chronox142857/FPGA2026/README.md

# FPGA2026 — FPGA 协议自识别逻辑分析仪

AMD 初级组 / 正点原子领航者 ZYNQ7010 / Vivado + SDK 2018.2。

本机主项目位置：`E:\FPGAproject\FPGA2026`。

原开发计划的逐项进度与后续分工见[项目状态（2026-10-31）](docs/PROJECT_STATUS.md)，区分实物通过、仅仿真通过、待开发及待修复项目。

交给另一开发对话的完整任务见[STM32独立信号源开发要求](docs/STM32_SIGNAL_SOURCE_REQUIREMENTS.md)：先确认具体板型，再生成已知UART/I²C/SPI信号。本对话维护FPGA主项目，单片机工程独立存放。

8 路、32 KiB 环形采样缓存，1/5/10/25/50 MSa/s；立即、上升沿、下降沿、电平组合触发；0/25/50/75% 预触发；ARM 裸机分析 UART / I²C / SPI；128×128 SPI TFT 显示与双按键操作。

**这是首版工程源码。仿真、构建和上板状态请看 [验证记录](docs/VALIDATION.md)。ST7735S独立PL例程已完成实物全屏填色验收；整合版由ARM提交四页界面及协议结果，KEY0切页已确认；UART/SPI已完成同板真实引脚回接，独立设备、完整性能范围及显示长期稳定性仍待验收。**

**后续实测更新：** 用户更换SDA线后，在GitHub原版下确认屏幕恢复；测试期间的碎字经全屏重画后清楚，局部刷新稳定性仍待专项验证。本轮保持发布版FPGA和显示初始化，仅修正ARM UART窗口起点与错误停止位后的帧对齐。12992组新增边界语料及原完整回归通过，板上正常/错误UART均已核对；连续采集和后续SPI结果见[验证记录](docs/VALIDATION.md)。未提高刷新速度。现已完成[SD卡首次独立冷启动](docs/SD_BOOT.md)：卡内保留BOOT.bin、BOOT_CFG 1/2均OFF，断电后可自动加载，不必每次JTAG下载；未写板载Flash。

SPI验证结果发布后，用户再次反馈上方约1/3乱码。未重新下载程序，仅请求整屏重画后用户确认乱码消失、文字清楚。因此显示稳定性仍未通过，不能将协议采集核对通过等同于整机显示验收完成。

## 当前整合版

SD启动保存版本：`sd-boot-20261031`，[BOOT.bin、校验与冷启动证据](releases/sd-boot-20261031/README.md)。BOOT_CFG 1/2均OFF，卡留在板内；日常JTAG调试不必反复拔卡，功能通过后再更新卡根目录BOOT.bin。JTAG临时程序断电后会被卡内版本替代。

本轮程序版本：`analyzer-selftest-20261031`，[程序、UART原始证据与恢复说明](releases/analyzer-selftest-20261031/README.md)。UART真实回接100次正常采集、8次错误停止位检查通过；同一程序又完成SPI四模式×四档预触发×AUTO/手动共32组实物核对，[SPI证据标签spi-loopback-20261031](releases/spi-loopback-20261031/README.md)。I2C等待上拉电阻，显示提速尚未开始。

版本标签`analyzer-st7735s-integrated-20261031`；[发布文件和恢复说明](releases/analyzer-st7735s-integrated-20261031/README.md)。保留已点亮的PL显示驱动，ARM负责采样读取、UART/I²C/SPI识别、四页界面和按键调度；显示初始化与PS复位隔离。KEY0短按切页，KEY1长按启动/取消采集，满屏刷新约1.2秒。测试源上电默认关闭，需要按接线文档回接后验证真实采集。

## 已验证的小屏版本

[ST7735S独立PL例程](examples/st7735s_pl/README.md)保存源码、接线、构建脚本及下载文件。当前文字版标签`st7735s-text-20261031`，采用原项目5×7字模，用户确认屏幕已有显示内容；`artifacts/`保存当前文字bit和电脑预览。已验证全屏五色版本仍保留标签`st7735s-fullscreen-20261030`及`artifacts/fullscreen_20261030/`配套bit/ltx。两版共享两段150ms等待和窗口偏移2/3，文字页明确标记DISPLAY TEST / CAPTURE OFF，真实采集数据尚未接入。

## 快速开始

在 PowerShell 中进入仓库目录：

```powershell
# 默认使用本机已发现的工具路径，可通过参数覆盖。
./scripts/test.ps1 # 含四页ARM画布→AXI→SPI全像素测试
./scripts/build.ps1 -Stage All
```

- `test.ps1`：编译运行可移植 C 分析器及界面测试；调用 XSim 验证 RTL；将 RTL 产生的 UART、I²C、SPI 四模式采样重新交给同一套 C 分析器验证。
- `build.ps1`：生成 block design、综合、实现、输出 bit/HDF，再构建 ARM ELF。
- 分阶段使用 `-Stage Project`、`Hardware`、`Software`。
- `-Vivado`、`-Sdk` 可覆盖安装路径；测试的 `-Gcc` 可指定 Windows GCC，`-HostOnly` 只运行 C 测试。
- 输出位于 `build/export/`。源代码不依赖已有 `.xpr`、其他人的生成文件或 2020.2 IP。

构建时临时用空闲 T:～Z: 映射仓库，结束后解除，以避开 2018.2 的 Windows 长路径问题。该过程不修改系统环境变量或删除工程文件。生成的工程引用这个短路径；直接用 Vivado 查看时需重新映射到构建时同一盘符，或在短目录下重新生成。

## 使用与文档

- [接线、屏幕配置和首次启动](docs/HARDWARE.md)
- [操作、串口命令、演示流程](docs/USER_GUIDE.md)
- [寄存器和软硬件接口](docs/INTERFACE.md)
- [验证结果与剩余事项](docs/VALIDATION.md)
- [架构、识别范围和局限](docs/ARCHITECTURE.md)
- [SD卡自动启动与调试/更新流程](docs/SD_BOOT.md)
- [当前完成度及后续分工](docs/PROJECT_STATUS.md)
- [转交STM32开发对话的信号源任务书](docs/STM32_SIGNAL_SOURCE_REQUIREMENTS.md)

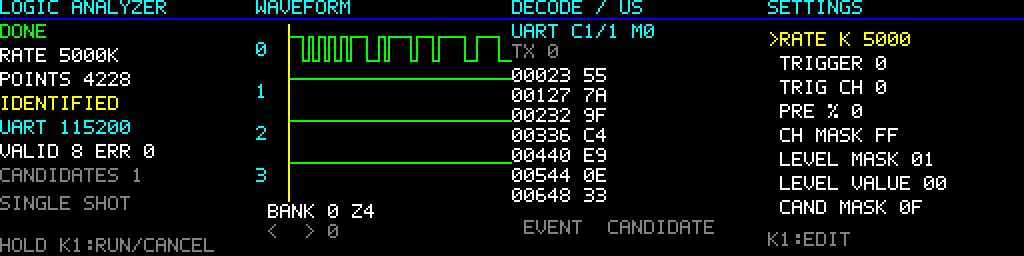
[picture p1: docs/ui-preview.png]
128×128屏幕四页布局预览（电脑渲染，2倍放大）


目录：`rtl/` 为 Verilog-2001；`firmware/` 为 ARM C 和可在电脑测试的分析器；`tests/` 为独立测试激励；`scripts/` 为重建、测试、调试入口；`constraints/` 为参考引脚约束。

## 实现选择

- 应用运行和采集使用 Cortex-A9 片内 OCM/PL BRAM；主工程关闭DDR。SD启动路径另由已核对的7010 FSBL初始化DDR，临时放置加载器再交接OCM应用，不是DDR采集功能。
- 所有 PL 数据通路、AXI 控制和 BRAM 控制器共享板上 50 MHz 时钟；PS 自己的时钟域由官方 AXI 接口处理。异步输入有两级同步，复位由 `proc_sys_reset` 同步释放。
- 先完成一次采集，再分析和显示；循环模式也有分析／显示间隙。
- 自动识别最多搜索 4 路候选通道。SPI 模式、收发方向可能有歧义，界面会显示 `AMBIGUOUS`，可手动指定。
- 评分表示规则匹配程度，不是经过统计标定的概率。测试集通过不表示所有未知信号都能被正确识别。
- 屏幕芯片确认是 ST7735S，屏体标记为 `14PIN HD14008H14 JY`，采用128×128 SPI方案；3.3V供电、偏移2/3、填色/文字和整合版KEY0翻页已实测，偶发局部乱码的长期稳定性仍待解决。
- 支持JTAG临时下载和已实测的SD独立启动，不自动写入Flash。日常调试用前者，固化可演示版本时更新卡内BOOT.bin。

## 参考资料

开发参考本机配套 FPGA 例程中的器件、时钟和引脚配置；未复制其带版权声明的 RTL。PS/AXI 使用 AMD 随 Vivado/SDK 提供的 IP 和驱动。控制芯片资料：[Sitronix ST7735S 数据手册（厂商镜像）](https://files.waveshare.com/upload/e/e2/ST7735S_V1.1_20111121.pdf)。同类模块参考：[Waveshare 128×128 SPI 屏说明](https://www.waveshare.com/wiki/1.44inch_LCD_HAT)，不代表本项目屏幕就是该模块。
