chronox142857/FPGA2026/docs/PROJECT_STATUS.md

# 原开发计划对照进度（2026-10-31）

本表按源码和最新验证证据归类。实物回接通过只覆盖记录中具体配置；仿真通过不能替代实物验收。当前主体已开发，整机最终验收尚未完成。最新记录见 VALIDATION.md，验收方法见 ACCEPTANCE.md。

## 已开发且有验证证据

| 内容 | 已验证范围 |
|---|---|
| 工程与工具链 | Vivado/SDK 2018.2重建、综合、实现、时序/DRC检查、ARM裸机程序构建通过，板上程序运行 |
| 采集与ARM读取闭环 | 8路/32768点/32KiB架构已实现；实物在5MSa/s下以UART单路、SPI四路回接，逐点核对ARM样本与冻结BRAM一致；不代表8路全部和所有采样档均已实测 |
| 触发、缓存、时间与配置锁存 | 五档采样使能、四类触发、四档预触发、回绕/冻结/取消/重复启动/配置锁存有RTL测试；四档预触发及下降沿触发另有实物记录 |
| UART识别和解析 | 同板115200 baud、8N1自动识别；100次正常采集通过，四档预触发各25次；8次坏停止位测试按手动UART参数核对错误及后续字节。异常流手动通过不算自动识别成功 |
| SPI识别和解析 | 同板100kHz、四模式×四档预触发×AUTO/手动共32组通过；AUTO保留正确候选并报告歧义，手动模式逐字节核对两方向和样本位置；不宣称AUTO唯一判断模式/方向 |
| 小屏基础显示与KEY0 | ST7735S初始化、窗口偏移、填色、文字、四页界面和KEY0切页有实物确认；画布到AXI到SPI像素路径另有仿真；显示长期稳定性另列未完成 |
| 自动化测试 | 原81项协议检查、12992组UART边界语料、100次缩小深度RTL采集、AXI、默认深度三协议贯通、显示像素路径通过；不能替代独立设备测试 |
| SD启动 | 首次独立冷启动通过，用户确认文字清楚和KEY0切页；只读核对SD模式、发布版主程序、接口和运行状态。卡保留、BOOT_CFG两位均OFF即可启动；未写Flash |

UART/SPI回接使用本板自测发生器，经外部短线回到真实采集输入，验证了完整引脚和软件链路；发生器与采集同源时钟，不能据此证明独立设备兼容性、相位适应性或绝对时钟精度。

## 已开发，但实物验证不完整

| 内容 | 剩余验证 |
|---|---|
| 8路输入、通道掩码与五档采样率 | 当前实物集中于CH0及CH0～3、5MSa/s；补8路、1/10/25/50MSa/s和掩码组合 |
| 四类触发和控制边界 | 补立即/上升/电平组合实物矩阵、长时间等待后回绕、取消和重复启动、采集中修改配置；检查会话统计和冻结窗口的区别 |
| 时间精度 | 用独立时钟改变相位和脉宽，核对同步延迟、采样量化、首/末边沿与计数；同板源不能标定绝对频率 |
| UART完整速率范围 | 外部源验证9600～1Mbaud、变化数据/空闲/截断/坏停止位及误识别；现有实物仅115200 |
| I²C | 解析器、自动角色判断、7位地址、方向、ACK/NACK、START/重复START/STOP及速率估计已写，软件/仿真通过；尚无实物通过记录，待带上拉的独立源验证100k/400k/1MHz |
| SPI完整指标 | 独立时钟、不同角色接线/数据图样、逐步提高至5MHz；已通过100kHz同板四模式不等于最高速验收 |
| 识别可靠性 | UNKNOWN/AMBIGUOUS、候选评分、手动参数已有实现及测试；补真实静态输入/反例/通道换序/三协议切换及固定测试集识别率、误判率统计 |
| 完整菜单交互 | 波形分组、缩放、平移、触发标记、解析翻页、设置、KEY1长按/取消/返回都有代码；KEY0已确认，其余要按真实操作逐项验收 |
| 单次与循环 | 主循环调度已写；UART测试器驱动100次通过，不能代替脱离JTAG、由按键启动的长期循环和所有协议稳定性验收 |
| 串口辅助配置/导出 | 参数命令、状态、dump已有代码；补完整命令和导出内容/使用体验的独立串口验收 |
| 局部刷新 | 影子画布、变化矩形已有实现及仿真；实物曾碎字/局部乱码，整屏重画恢复，根因尚未定，稳定性未通过 |
| 板载自测源 | UART/SPI实物已用，I²C仅仿真贯通；源固定速率，不能覆盖完整速率范围 |
| SD启动复现 | 首次冷启动已通过；多次冷启动统计、长时间独立运行未做 |

解析结果当前最多保留前128个条目并记录溢出，原始32768点仍完整保存。尚未实现任意长度解析结果全部浏览。

## 尚未开发或未完成的交付项

| 内容 | 当前边界 |
|---|---|
| 提高刷新率/专门加速数字区 | 尚未开始；先解决乱码与局部更新稳定性，再验证提速和非阻塞交互 |
| 新800×480 RGB屏与触摸 | 尚未实现RGB时序、显示缓存/带宽方案、GT1151/GT9147触摸及新界面布局；这些GT型号是触摸控制器，不代表LCD显示驱动 |
| 完整比赛演示和验收包 | 未完成三类独立输入的采集→识别→解析→显示、异常/无法确定演示、录像、最终复现说明及正式赛题指标逐条核对 |
| 扩展项 | SD历史记录、DDR深度采集、DMA、更多协议、板载Flash自动启动尚未开发。SD启动文件已实现，不等于SD历史记录已实现；启动临时使用DDR，不等于DDR采集已实现 |

当前显示使用已经点亮的Verilog ST7735S驱动和AXI画布桥，ARM负责界面。原计划的AXI Quad SPI+GPIO显示方案已由此方案替代，不能再把旧方案计作待实现模块。

## 后续分工和顺序

- 本对话负责领航者板上的Verilog采样/触发/缓存/接口、ARM裸机识别和解析、显示/按键/启动、测试与文档。
- 外部STM32等单片机信号源由用户另一个对话开发，本对话不承担该固件实现，也不自动给另一个对话发送消息。
- 可直接转交另一对话的任务书见[STM32独立信号源开发要求](STM32_SIGNAL_SOURCE_REQUIREMENTS.md)，明确型号确认、接线、独立操作、测试包、协议/异常用例及交付物。
- 原范围识别UART、I²C、SPI。若单片机发送自定义上层业务帧，当前恢复底层字节，不会自动理解新增业务协议语义。
- 优先补显示稳定性与板内可独立完成的验收；外部源就绪后导入已知数据和源参数，完成独立时钟、完整速率、触发/异常/角色换序测试，再完成三协议演示。
- 使用现有小屏无需新显示模块；I²C总线需要合适的上拉，若信号源已有则核对后复用。外部源与采集端共地，使用与当前输入匹配的3.3V逻辑。具体信号源板引脚由另一对话确定。

版本保存：UART程序标签`analyzer-selftest-20261031`，SPI证据标签`spi-loopback-20261031`，本次SD启动文件与证据保存于[sd-boot-20261031](../releases/sd-boot-20261031/README.md)，配套源码/重建脚本和本状态说明随本次更新提交。项目位置为 `E:\FPGAproject\FPGA2026`。
