chronox142857/FPGA2026/docs/VALIDATION.md

# 验证记录

验证日期：2026-10-29～31，Asia/Shanghai。主项目：`E:\FPGAproject\FPGA2026`。

阅读顺序：本文件保留各阶段原始结论，包括后来修复的失败；以[当前项目状态](PROJECT_STATUS.md)及本文件顶部后续验收为准。外部单片机开发边界和测试激励见[信号源需求书](STM32_SIGNAL_SOURCE_REQUIREMENTS.md)。

## SD卡首次独立冷启动（2026-10-31）

原7010纯PL固化FSBL能从卡加载FPGA、DDR加载器和完整应用，但在0xE6E4停住、未调用已有FsblHandoff。核对具体供应商ELF哈希和指令后，构建脚本仅修正该交接指令；现有FPGA bit、ARM ELF、显示初始化、250kHz SPI均不变。先用JTAG临时交接验证路径，用户确认文字和翻页正常，此项单独标为辅助验证。

随后修正版BOOT.bin写入用户确认的D: FAT32可移动卡并读回校验。用户安全移卡、开发板OFF/OFF冷启动后确认文字清楚、KEY0能切页。只读复核BOOT_MODE=5，REBOOT_STATUS=0x00400000，OCM主程序与发布ELF一致，采集/显示ID正确、显示状态=1、帧数=5、screen_ok=1、应用循环时间持续前进。复核期间没有下载、暂停CPU、复位或写目标寄存器。日志：`build/sd_boot/cold_check/20261031_170331_569427/status.log`，启动文件SHA256为`857c88573bd738ccbe17c9ef34cbe2df8b012ae5407ca8e580d948f7fd58fbff`。

首次完整冷启动通过；卡必须保留在板内。未做多次冷启动统计、未写Flash，不据此关闭偶发显示乱码问题。构建依赖准确的本地7010 FSBL；启动阶段使用其DDR初始化，应用采样/分析仍用原OCM和BRAM布局。步骤见[SD启动说明](SD_BOOT.md)。下文早期“仅JTAG启动”记录为当时状态。

## 换SDA线后恢复与本轮UART修正（2026-10-31）

用户更换SDA杜邦线后，在同一份3b3488e原bit/ELF下反馈屏幕恢复正常。这支持继续检查信号连接的判断，但没有测量线材通断/动态波形，不能断言此前所有白屏的唯一原因就是该线。随后UART测试期间，用户反馈能切页但文字呈碎点；通过已有first_frame标志请求全屏重画后，用户确认文字清楚。此轮未提高SPI时钟或数字刷新频率，局部刷新稳定性仍待专项验证。

测试发现正常UART在75%预触发、窗口从字节中间开始时，会把残缺片段误报成FE字节。使用保存的真实32768点样本复现后修正：优先利用观察到的完整空闲区间确定帧起点，开头不可信片段标记TRUNCATED；长空闲后的有效帧不反过来为之前残片提供锁帧证据；停止位错误与下一起始位同为低电平时保留已知位边界，避免把下一数据边沿当作起始位。丢弃较大前缀会降低候选评分，保留原非标准波特率测试，避免更高波特率谐波因裁剪前缀获得更高分。

- 新增独立绝对时刻波形/数据/错误标志核对：12992个窗口，变化起始相位和16种起始数据，正常与错误停止位均通过。此语料带包间空闲，不证明任意无空闲波形都能唯一恢复帧边界。
- 原81项协议测试、100次缩小深度采集仿真、AXI测试、默认32768点UART/I2C/SPI四模式贯通，以及ARM画布→AXI→SPI五帧全像素/局部矩形测试均通过。
- SDK2018.2生成新ARM ELF，text=46872、data=1152、bss=127616；OCM布局上界仍为0x2B280。仅临时更新ARM，FPGA仍为发布版bit（SHA256=5a5ab497473bd2c398564e56c259ac9d310481d47916d911369a5ff6a4363a16），未更改显示初始化。
- 新ARM在75%预触发实测正常，32768点、5MSa/s、AUTO UART115200、40个有效字节、0错误；错误源用手动UART115200核对，39个有效字节、6个错误停止位，所有完整输出字节仍符合0x13递增及独立位中心核对。异常源此项是手动参数验证，不计作异常流自动识别成功。
- 100次真实UART回接全部通过：0/25/50/75%预触发各25次，32768点、5MSa/s、AUTO UART115200，每次40～48个有效字节且0错误，100个触发时间戳严格递增。每次都逐字节比较冻结BRAM和ARM样本，并核对触发位置、时间关系及已知数据序列。测试器在记录之间短暂停ARM导出证据，不等同于无间隙实时采集或已完成所有协议的100次验收。
- 另做8次错误停止位实物回接，四档预触发各2次，手动UART115200；每次35～42个有效字节、5～6个错误停止位，完整字节和错误标记均通过独立位中心及0x13序列核对。已锁定的本测试源在坏停止位后能维持字节边界，不代表任意BREAK/噪声条件都能恢复。
- 汇总保存在`build/hardware_selftest/20261031_154836_035254_uart0/`（100次正常）和`20261031_155206_805771_uart-error0/`（8次异常）。UART程序和证据已发布为analyzer-selftest-20261031；SPI后续实测见下节，I2C缺少上拉电阻，尚未执行实物测试。

本轮正常板载源约115200 baud，不能替代9,600～1,000,000 baud异步独立设备验证；源和采样同板共时钟，不能标定绝对频率。测试脚本在结果页请求全屏重画，不等同于已实现局部数字刷新优化。

## SPI四模式真实回接（2026-10-31）

用户确认四根SPI短线回接完成后，完整重新下载analyzer-selftest-20261031保存的bit和ELF。FPGA bit及ARM ELF的SHA256分别仍为5a5ab497473bd2c398564e56c259ac9d310481d47916d911369a5ff6a4363a16及7f78db8cf2852305b9eed6ad6f7f657b1fb02c0b58c62bafa363501b4177d4e8；没有修改固件或显示参数。

| 源模式 | AUTO（四档预触发） | 已知模式/角色手动核对（四档预触发） |
|---|---|---|
| SPI 0 | 4/4通过 | 4/4通过 |
| SPI 1 | 4/4通过 | 4/4通过 |
| SPI 2 | 4/4通过 | 4/4通过 |
| SPI 3 | 4/4通过 | 4/4通过 |

- 共32组完整矩阵，5MSa/s、32768点，0/25/50/75%预触发，每次触发于CH3的CS下降沿。逐点比较ARM读取和按环形起点展开的物理BRAM；检查触发索引、CS边沿、启用通道、时间戳关系，32次触发时间均不同。
- 16次AUTO均首选SPI、100000Hz、AMBIGUOUS；候选包含实际接线角色SCK/MOSI/MISO/CS及源模式，未把收发方向或相位歧义误报为唯一确定。AUTO并不等同于已唯一确定实际模式。
- 16次手动核对指定实际角色及模式。独立读取原始物理线路的已知采样边沿，对完整CS区间核对两字节相同、后续事务按0x13递增、MISO与MOSI互补；每次19～20个完整事务，ARM输出字节及起止样本序号与该核对一致。
- 每次共有39～41个完整字节，末尾另有1个采集窗口截断标记。已断言该错误计数仅来自end_sample=32767的TRUNCATED DESELECT，完整CS事务没有结构错误；不把窗口末尾截断当成源产生了坏帧，也不把它隐藏成0错误。
- 全部32组在导出后再次用最终核对脚本离线重验，覆盖新增的CS下降沿和窗口末尾截断断言。程序/FPGA无需重编译。最后另做一次模式0 AUTO并留在解析页，关闭自测输出；运行状态核查通过，ARM恢复运行。
- 用户确认重新上电下载后“小屏文字清楚，显示正常”。测试结果页使用整屏重画，没有提高刷新速度；不据此宣称局部刷新稳定性或长期显示验收已完成。

发布证据：`releases/spi-loopback-20261031/`，含32组汇总、完整原始采样/寄存器/事件压缩包、最终运行状态及SHA256。源码程序仍使用前一标签的同一份产物。尚未进行SPI最高5MHz、独立从机/独立时钟、更多字长/位序或SPI实物100次循环验证；UART100次不能替代这些项目。

### SPI验证之后再次局部乱码

SPI证据提交/推送期间，用户报告上方约1/3出现乱码，并询问是否正在更新板上程序。当时仅在进行GitHub操作，没有重新下载固件或修改刷新速度，发生器输出已关闭。收到反馈后只读两次显示状态，间隔1秒，帧计数均为37（0x25），状态1；主机ui_pixels与shadow逐字节一致。此观测不证明乱码出现的确切时刻没有其他刷新，也不证明实际LCD收到的像素正确。

随后根据当前ELF动态取得first_frame/last_paint符号地址，暂停ARM设置整帧重画标志后恢复，没有复位FPGA或重发初始化。2秒后帧计数38（0x26），用户确认“乱码消失，文字清楚”。日志和画布快照在`build/spi_corruption_full_refresh.log`、`build/spi_corruption_ui.bin`及`build/spi_corruption_shadow.bin`。这再次证明该次异常可由整屏重画恢复，不能据此确定是局部刷新实现、串行传输还是电气因素中的哪一项导致。

当前显示稳定性仍未验收；UART/SPI原始采集与解析的核对结果保留，不等同于整机显示验收。后续刷新率优化应先处理局部乱码复现和整帧恢复条件，不将一次清晰画面当作长期稳定。

## 历史实测与白屏复现（2026-10-31，UART修正前）

2026-10-31后续已用短线P15→W18完成真实UART回接，使用既有FPGA发生器、同一块板的时钟，非独立设备验证：

- 5MSa/s、32768点、115200 baud；正常UART的0/25/50/75%预触发均通过。实际触发索引0/8192/16384/24576，下降沿与元数据时间关系正确。
- 每次ARM样本与冻结BRAM按环形起点展开后32768字节完全相同；自动UART结果115200，完整字节按0x13递增，46～48个有效字节、0帧错误。另有初次25%记录47字节。
- 故意破坏停止位时检出错误，但异常之后的字节序列恢复检查失败；不能将错误计数增加当作完整异常恢复验收。原始数据保存在`build/hardware_selftest/*_uart-error0/`，正常记录在相邻目录。该问题尚未修复。
- 用户反馈白屏持续，确认没有按复位或插拔操作，但不确定何时开始。只读检查显示ARM刷新计时继续更新、记录和UART识别正常、显示状态无内部错误；这不能证明LCD正确收到并显示。
- 按用户要求重新下载Git标签保存的整合bit/ELF，校验完全相同，用户仍反馈全白屏、LED0闪。因此原来的菜单点亮不能稳定复现，显示稳定性验收不通过，协议自测已暂停。

历史启动实验：显示桥版本改为0x4C440102，上电保持LCD复位，ARM在PS启动和MMIO可用后通过COMMAND=4明确启动初始化。原初始化字节和150ms等待不变。新增ARM显式启动/重复初始化仿真通过，但用户反馈仍全白，实验没有解决故障。当前源码已恢复发布版0x4C440101，失败实验备份保留在build中。

实验版当时已完成Vivado/SDK构建并临时下载，显示ID=0x4C440102、screen_ok=1、首帧完成。WNS+8.625ns、WHS+0.040ns，TNS/THS=0；LUT2187、FF3181、BRAM16、DSP2。候选修改和构建日志保存在`build/display_explicit_start_snapshot/`，源码备份在`build/failed_display_start_source/`；不作为当前板上版本或成功显示证据。

## 早期整合版快照（2026-10-31）

主体采集/协议分析/四页界面已接入已点亮的ST7735S Verilog驱动。此节记录初次整合时的状态；后续UART/SPI/SD启动结果见本文件上方，不能将下方“尚未回接”等旧结论视为当前状态。2026-10-29～30的ARM SPI/GPIO排查与资源数字同样保留为历史。

- 保留独立例程驱动原文件：profile 2、窗口偏移2/3、MADCTL C8、两段150ms等待、约250kHz、字节末SCK高；没有重写已点亮的初始化。
- 新增`la_display`，AXI 0x44A00000、32KiB PL画布和矩形刷新；采集缓存与显示缓存独立。ARM不直接操作屏幕引脚、不读取LCD寄存器。旧色块诊断循环移除，正常运行采集/分析/菜单。
- 完整`test.ps1`通过：81项协议检查、100次仿真采集、AXI、默认32768点的UART/I2C/SPI四模式贯通、UART错误注入、旧pad回归。
- 新增生产C画面/传输测试：用RTL UART样本进行真实解码，生产`ui.c/tft.c`生成四页画面及MMIO轨迹，Verilog重放AXI并从实际SPI输出重建GRAM，四页全部16384像素相同；另有局部修改第五帧、部分byte strobe/奇数坐标矩形、忙时拒写、无变化跳过、越界拒绝、初始化77字节和150ms等待检查。`test_display.c`还覆盖初始化错误/超时与空指针。
- Vivado2018.2完成重建、综合、布局布线和bit/HDF生成；WNS +9.878ns、WHS +0.041ns，TNS/THS=0；LUT2046、FF3115、BRAM16、DSP2；DRC无错误/严重警告，五条普通DSP流水线建议。
- SDK2018.2严格警告编译并链接成功：text46488、data1152、bss127616字节；链接末地址0x2B280，低192KiB OCM剩余19840字节；堆栈已计入布局。
- 第一版整合程序虽通过仿真，用户仍反馈白屏。随后将显示复位与PS/AXI复位分离，保留独立版65536周期上电等待与两级同步释放，同时将DC/RES/BLK的驱动强度/边沿设置与成功版完全对齐。新增PS/AXI复位发生在LCD初始化恢复期间的隔离仿真，通过且77字节初始化保持完整。此处同时修正了两类差异，未单独证明哪一项是白屏的唯一原因。
- 最终整合版已下载bit/ELF，用户明确确认“界面正常，KEY0能切页”。调试确认ARM正常运行、screen_ok=1、采集ID=0x4C410101、显示ID=0x4C440101、显示状态=1、完成刷新次数=13、菜单刷新计时已更新；核查后恢复ARM运行。
- 真实输入尚未回接，record.count=0。因此只确认界面与KEY0翻页，不宣称真实采集/识别或上板100次采集已经验收。KEY1长按、外部UART/I2C/SPI和最大协议速率仍待实测。

当前日志：`build/integrated_reset_build_20261031.log`、`build/integrated_regression_20261031.log`、`build/integrated_reset_display_test_20261031.log`、`build/integrated_reset_program_20261031.log`、`build/integrated_final_status_20261031.log`。发布快照位于`releases/analyzer-st7735s-integrated-20261031/`；日常构建产物在`build/export/`，SHA256SUMS随构建更新。不要使用旧GPIO诊断脚本访问已移除的0x41200000。

下面为旧ARM显示通路的历史记录及此前采集/协议测试细节，资源数字以本节整合版为准。

## 已通过

| 项目 | 结果与范围 |
|---|---|
| 协议 C 测试 | 81 项检查通过：9档常见 UART 波特率、非标准17123 baud、停止位错误、截断、I²C三档速率/重复START/ACK/NACK、SPI四模式及5MHz、静态/30组确定性噪声、采样不足、手动设置等 |
| 采集 RTL | XSim 2018.2，100次采集通过；测试深度32点，以覆盖5档分频×4种触发×4种预触发的完整组合，并变化通道掩码；检查同步数据、时间、环形回绕、最后一笔写、忙时ARM、锁存配置、非法参数、WAIT/POST取消 |
| AXI RTL | AW先到/W先到/同时到、R/B背压、byte strobe、ID、ARM/CANCEL、记录元数据检查通过 |
| 默认深度贯通 | 使用默认32768点，Verilog发生器→采集核心→导出原始采样→同一套C分析器，共7组：正常UART、I²C、SPI0..3、错误UART |
| 数据内容核对 | 正常UART逐字节检查0x13递增序列；I²C检查地址A0；SPI四模式逐字节检查两方向按位取反关系 |
| 异常演示源 | Verilog UART停止位错误注入，在完整采样中检测到14个帧错误；保留错误条目，不计入正常字节 |
| 界面 | 四页离屏渲染、掩码菜单约束、返回操作、有边界的整数格式化测试通过，并人工查看布局预览 |
| 工程重建 | Vivado 2018.2实际执行脚本，block design验证通过；外部复位低有效、辅助复位高有效且接低；验证后断言两者极性；关闭DDR |
| 综合与实现 | 实际完成综合、布局布线、bitstream生成；没有错误和严重警告；设计规则检查只剩3条DSP流水线建议 |
| ARM构建 | SDK 2018.2，Cortex-A9/VFPv3/hard-float，Release -Os，应用源码开启-Wall -Wextra -Werror -std=c99；实际链接成功 |

RTL与C贯通结果：UART识别115200 baud；I²C识别100000 Hz；SPI0..3均包含SPI候选并报告AMBIGUOUS，各自约100000 Hz。候选数量随波形不同，为5或6，符合保留模式/方向歧义的策略。噪声测试不代表对任意未知输入的全局误判率。

## 资源与时序

器件 `xc7z010clg400-1`，当前SPI分频16的实现报告：

| 资源 | 使用 | 比例 |
|---|---:|---:|
| LUT | 2122 / 17600 | 12.06% |
| 寄存器 | 3346 / 35200 | 9.51% |
| BRAM | 8 / 60 | 13.33% |
| DSP | 1 / 80 | 1.25% |

50MHz约束下，WNS **+7.561ns**，TNS 0；WHS **+0.037ns**，THS 0；脉宽检查无失败。用户指定时序约束满足。外部探头、异步UART和实际屏幕的电气/时序表现仍需硬件验证，不能由内部时序通过代替。

三条剩余DRC普通警告为 DPIP-1、DPOP-1、DPOP-2，均针对触发时间偏移乘法器未额外流水化的性能建议；当前时序已满足。自测IO已显式使用IOBUF，原先的三态转换/缓冲不完整问题已修正。

ARM `size`：text=53216、data=1200、bss=127760字节，总和182176字节。考虑MMU表对齐、堆栈等布局后，链接末地址为 `0x0002F310`，小于低OCM的上限 `0x00030000`，剩余3312字节。堆栈已在链接脚本中预留；后续扩展须重新核对布局。当前不使用DDR。

## 产物与复现

- `build/export/system.bit`：FPGA配置文件。
- `build/export/system.hdf`：含bitstream的SDK硬件定义。
- `build/export/analyzer.elf`：ARM程序。
- `build/export/analyzer.map`：内存布局。
- `build/timing_summary.rpt`、`utilization.rpt`、`drc.rpt`：实际实现报告。
- `build/tests/tb_capture.log`、`tb_axi.log`、`tb_loopback.log`：XSim结果。
- `build/tests/loop_*.hex`：RTL产生的默认深度原始采样。
- `docs/ui-preview.png`：电脑渲染的2倍放大布局预览，不是上板照片。

从源码复现：`./scripts/test.ps1`，然后 `./scripts/build.ps1 -Stage All`。构建及测试生成文件已忽略，不依赖远程仓库保存缓存。测试默认使用本机已有的Windows GCC，其他电脑可通过-Gcc覆盖。

## 尚未完成的真实硬件验收

已完成 JTAG 临时下载和下节列出的运行检查；尚未完成真实采集内容/ARM读取BRAM验证、真实屏幕显示验收、真实按键、电气波形、最大协议速率或上板100次连续采集。屏幕芯片已由用户确认是ST7735S，标记为 `14PIN HD14008H14 JY`；仍需核对板卡修订版/排针编号、PS参考时钟、屏幕供电/偏移/方向/背光电路，按HARDWARE.md和USER_GUIDE.md上板逐项验收。

## 首次上板与复位修复（2026-10-29 23:30）

实际连接的 JTAG 链识别到 xc7z010 与两个 Cortex-A9。首次下载原配置后，ARM访问PL超时且调试暂停失败；检查生成IP发现 `C_AUX_RESET_HIGH=0`，而 `aux_reset_in` 接低，导致AXI外设一直复位。RTL核心仿真不包含此复位IP集成，不能由之前的核心仿真通过推断整机可运行。

修复：工程脚本明确设 `C_AUX_RESET_HIGH=1`，保留外部复位低有效，并在设计验证后断言两种极性。重新完成全量 Vivado/SDK 构建；上表FPGA资源、时序及DRC保持相同数值；后续增加启动色条检查，ARM最新size已更新，OCM布局末地址保持不变。更新了 `build/export/SHA256SUMS.txt`。

通过 JTAG 重新配置 FPGA 后，曾经超时的调试接口恢复，无需用户断电。随后重新下载 bit/ELF，实际通过以下检查：

- ARM启动前通过调试接口读 `0x43C00000 = 0x4C410101`；下载脚本已加入此检查，失败时不启动应用，并返回非零退出码。
- ARM主核运行；可正常暂停和恢复，最后保持运行状态。
- 运行后采集状态为IDLE，默认mask=FF、divider=1。
- 固件变量 `screen_ok=1`，表明SPI驱动初始化返回成功；`last_paint`已更新，表明执行过界面刷新。
- 显示GPIO数据寄存器 `0x41200000 = 0x7`：DC、RES、BLK的输出控制值均为高；这不代替针脚电压实测或屏幕亮度确认。

日志：`build/reset_fix_build.log`、`build/jtag_download.log`、`build/jtag_verify.log`。电脑没有识别到串口端口，因此没有取得真实串口启动日志。用户在修复前反馈小屏完全不亮，修复后背光亮起。随后加入启动5秒色条检查（成功后强制重绘界面），只重建ARM程序并下载。用户曾在下载后关电/重新插线，导致易失配置丢失，调试观察到CPU回到启动ROM；再次完整下载后，版本ID、screen_ok、GPIO与界面刷新计时再次检查通过，用户最新反馈为花屏。已取得花屏正面及已连接信号线照片：画面为全屏随机彩色噪点；从屏幕侧面线序判断蓝线对应DC，而开发板照片中蓝线位于R16/R17列，外排R18未见接线，与当前DC=R18的约束不符。已提示用户断电核实蓝线屏幕端为DC，并将开发板端移到外排R18（灰色Y19与黄色V18之间）；用户随后确认已改好线；已再次完整临时下载 bit/ELF，读回ID=0x4C410101、screen_ok=1、显示GPIO=0x7，界面刷新计时更新，检查后恢复ARM运行。改线后用户反馈白屏；后续对照测试见下节，尚不能写作屏幕验收通过。

本次没有修改屏幕电源/Gamma/偏移等初始化参数；只增加启动色条检查，没有烧写QSPI或SD卡。

## 降速对照与当前状态（2026-10-30）

用户确认小屏端线色为：GND棕、VCC白、SCL橙、SDA黄、RES绿、DC蓝、CS紫、BLK灰。当前尚缺改线后的J3近照，不能据旧照片证明蓝线已位于外排R18。

SPI分频由8改为16，名义时钟由6.25降至3.125MHz。2018.2此IP合法分频为2/4/8/16，最初尝试64被参数校验拒绝，未生成该配置的bit，也未下载该无效配置。保持采集主时钟、引脚、ARM源码和屏幕初始化电源/Gamma/偏移参数不变。成功完成综合/实现/时序/DRC及SDK更新，当前资源/时序表已更新；旧6.25MHz产物保存在 `build/diagnostic/fast_spi/`，当前有效产物与校验和位于 `build/export/`。

部分观察期间用户按过复位，CPU回到ROM，随后调试AP访问超时；软件尝试先重新配置PL未恢复该次DAP，用户完整关电约5秒后恢复。再次完整下载后，实际检查：CPU处于应用代码 `0x00006948`，ID=0x4C410101、screen_ok=1、GPIO=0x7，界面刷新计时非零，检查后已恢复CPU运行。用户在本次保持运行条件下仍反馈均匀白屏；不能认为单纯降速已解决问题，仍需改线后的照片及必要的针脚电压/波形核对。

发现SDK2018.2的xsct.bat在某些Tcl失败时仍向PowerShell返回0；`program_jtag.ps1`因此额外检查明确成功标记，失败不报告下载完成。该包装脚本已通过语法检查，并已用于改接3.3V后及SDA诊断版本的实际下载，均确认成功标记。Tcl脚本新增一次PL优先配置恢复尝试，失败时仍需实物断电恢复，不能宣称自动恢复所有调试故障。

## 供电前提修正（2026-10-30）

用户在检查接线后补充：小屏VCC实际直接接5V。此前接线方案要求3.3V，但没有取得电源针脚或电压的可靠验证，不能将之前的白屏观察当作3.3V条件下的测试结果。

ST7735S手册第20/21页：VDD工作2.5～4.8V，VDDI正常工作1.65～3.7V，VDDI绝对最大4.6V。模块外接VCC不能直接等同芯片任一内部电源；只有模块明确具备相应稳压/电平电路才能支持5V输入。实物照片中未见明显独立稳压芯片，尚无模块原理图，因此不确认5V兼容，也不能仅凭白屏断言已损坏。

已要求先断电，将白色VCC线从5V移到开发板明确标注3.3V的电源针，其余接线保持原位，待用户确认后再完整临时下载。用户已确认改接3.3V并重新上电，完整下载后仍反馈白屏；后续SDA诊断版本也未取得有效应答，见下节。

依据：[ST7735S V1.1数据手册](https://files.waveshare.com/upload/e/e2/ST7735S_V1.1_20111121.pdf)。

当前启动方式为JTAG易失性下载，断电后需重新下载。SD/QSPI独立启动、DDR深度缓存、DMA、历史记录和额外协议不属于此次首版交付。

## SDA读回诊断与万用表实测（2026-10-30）

增加`la_tft_pad`：正常模式保持硬件SPI写入，诊断模式通过GPIO接管SCK/SDA/CS，SDA使用IOBUF切换为输入并由GPIO通道2读回。外接线与球位不变；V18加入内部上拉。读命令按ST7735S手册要求在最后一个命令时钟下降沿前释放SDA，保留32位原始响应以免误用不同命令的dummy位规则。

- XSim 2018.2新增`tb_tft_pad`通过，覆盖硬件SPI透传、GPIO覆盖、SDA高阻/外部驱动/释放上拉，以及恢复硬件SPI；这不代替实物时序验证。
- 已完整临时下载诊断版本，ARM确认运行并在检查后恢复。`tft_diag_flags=0x53500106`：已完成探测，SDA驱动低/高/释放分别读到0/1/1。
- 04、DA、DB、DC、0A、0B、0C、09的八个原始响应均为`0xFFFFFFFF`。只能记录为未取得有效显示芯片应答；不据此认定屏幕损坏，也不排除模块读回走线等因素。
- 用户以屏幕端GND为参考实测：VCC=3.2728V、RES=3.30V、CS=3.30V。测量期间保持原程序运行，没有再次下载。静态电平正常，不证明SPI波形或上电复位脉冲正确。
- 初版诊断实现遇到SPI IP的SCK触发器IOB打包提示与新增GPIO复用器不兼容；在独立的后处理实现约束中将该触发器IOB属性设为FALSE。清理版已在电脑完成实现及SDK构建，无错误及严重警告，DRC保留3条DSP普通建议；暂未下载。初次清理构建中XDC不支持if检查产生的严重警告也已移除并重建确认。最终日志：`build/readback_constraint_fix.log`。

用户提供参考资源：[STM32F103 / 128×128 ST7735S HAL例程](https://download.csdn.net/download/u010173859/34651148)。已取得公开网页，目录含`bsp_lcd.c`（5990字节）、`bsp_lcd.h`（2191字节）、`gpio.c`和`main.c`，压缩包3.77MB、共106个文件，页面标注47积分。尚未取得压缩包或驱动源码，因此没有据其修改初始化值。页面简介标注AIGC且混杂并口接线叙述，不能代替实际SPI源码或原厂模块资料；芯片及分辨率相同也不足以独立确认面板批次一致。

### 屏幕端静态电平验证（已结束，现已恢复运行）

取得上述三项电压读数后，使用JTAG暂停ARM于应用PC=0x00006B98，确认采集ID仍为0x4C410101，然后将GPIO控制从0x07改为0x3E。当前诊断覆盖已启用：SCL=1、SDA=1、DC=0、CS=0、RES=1、BLK=1；GPIO通道2确实读回SDA=1。没有复位或重新下载。ARM暂时保持暂停，等待用户测量屏幕端SCL/SDA/DC/CS直流电压；屏幕此时不刷新，不用于显示效果验收。日志：`build/panel_static_levels.log`。

恢复时先将GPIO写回7再恢复ARM；如需重新判定显示效果，应重新完整初始化屏幕或下载启动程序。诊断留下的半次SPI事务不能作为正常显示观察条件。

用户随后反馈第一组四项均符合预期，低电平约为-0.006V（可视为0V）。因此这些针脚在该组设置下的屏幕端静态电平与预期一致；仍不能据此排除同电平信号互换或证明高速时序。

已切换第二组：GPIO=0x8F，SCL=0、SDA=0、DC=1、CS=1，RES和BLK继续为1；GPIO通道2读回SDA=0，采集ID与暂停PC未变。ARM继续暂停，等待屏幕端第二组实测。日志：`build/panel_static_reverse.log`。此阶段未重新编译、下载或复位。

用户反馈第二组也全部符合。随后设置第三组交错电平GPIO=0x1F：SCL=1、SDA=0、DC=1、CS=0，RES/BLK保持1，用户再次确认全部符合。三组组合使四根信号分别具有不同电平序列，可区分这四根线之间的互换和直流固定电平故障；不代替SPI时序、电源纹波、接触稳定性或屏体FPC内部连通性验证。第三组日志：`build/panel_static_cross.log`。

### 低速GPIO发送对照（当前板上版本）

`TFT_SOFTWARE_SPI=1`启用临时诊断发送方式；设置为0可恢复AXI Quad SPI发送。保持现有初始化命令、数值、偏移和外接线不变。GPIO按SPI模式0、8位MSB优先发送，SCK低时改数据，升沿采样，CS在一笔发送中保持低。每阶段等待2us，名义上限125kHz，实际还含GPIO和循环开销，未用示波器测量真实频率。

已通过SDK2018.2编译及链接（源码-Wall -Wextra -Werror），生成text=53208、data=1200、bss=127760，OCM末地址仍0x2F310。已重新完整下载清理版bit与GPIO发送ELF，正常启动并复位初始化显示芯片，先前的静态测试暂停状态已结束。检查ID=0x4C410101、screen_ok=1，ARM可暂停/恢复并最终处于运行状态。首次检查last_paint仍为0、PC位于usleep，可能仍在启动色条阶段，不能据此声称界面已刷新；已请用户等待20秒观察。日志：`build/soft_spi_build.log`、`soft_spi_download.log`、`soft_spi_verify.log`。屏幕结果待用户反馈。

启动后再次检查last_paint=0xB89A（非零），GPIO=0x8F（诊断发送覆盖、CS高、SCK低），说明已完成首次界面发送并回到主循环；检查后恢复CPU运行。日志：`build/soft_spi_verify_after_startup.log`。这些运行证据仍不能代替屏幕显示效果的实物确认。

## 完整厂商参考初始化首次点亮（2026-10-30）

- 原初始化保持不变的低速GPIO版本，用户等待后仍反馈均匀白屏。因此仅绕过AXI Quad SPI和降速没有解决问题。
- JTAG暂停并将GPIO设为0x8D，RES=0、CS=1；用户在屏幕端测得RES=0V。用户另提到曾在通电时误用欧姆档读得6Ω，该读数无效，未将其记录为实际阻值或短路证据。随后GPIO恢复0x8F并恢复CPU运行。
- 从Waveshare官方页面取得免费例程：<https://files.waveshare.com/upload/f/fa/1.44inch-LCD-HAT-Code.7z>，对照`LCD_1in44.c`（2023-06-05）。它是相同芯片和分辨率的另一款模块，不能当作HD14008H14 JY原厂确认资料。
- 新增`TFT_INIT_PROFILE=1`：保留原有主要电源/Gamma数值，补充B3、B4、C4和例程中的F0/F6配置；采用高100ms、低100ms、高100ms硬复位；先寄存器初始化、再退出休眠等待120ms、再开启显示。原有配置保留为profile=0。MADCTL仍0xC8、偏移2/3未变，低速GPIO发送仍启用。
- 完成SDK构建及完整临时下载，用户明确反馈“出现色条或文字”。这是首次用户确认屏幕点亮；尚未取得照片，未确认文字方向、RGB顺序、边界、完整菜单和连续刷新。
- 多个初始化差异一起引入，当前只能确认整套参考序列有效，不能归因于单独某个寄存器或顺序差异。

首个可用低速版本及源码快照已备份到`build/diagnostic/first_light_gpio/`（bit/HDF/ELF/map及board_config.h、tft.c、main.c）。日志：`build/panel_reference_profile_build.log`、`panel_reference_profile_download.log`。该版size为text=53344、data=1200、bss=127760；OCM末地址仍0x2F310。

后续保持profile=1，仅将`TFT_SOFTWARE_SPI`改为0，重建硬件SPI发送版，用于确认3.125MHz下能否保持显示。结果待测；首个可用低速版本已保留，不覆盖其备份。

首次点亮后读回仍为八组0xFFFFFFFF，flags=0x53500106；screen_ok=1、last_paint非零，检查后恢复CPU。因此该实物模块在当前读回方式下“全1响应”与正常显示可以同时出现，不能把ID读回当作是否能显示的必要条件，也不能据其判坏。日志：`build/first_light_gpio_verify.log`。

硬件SPI/profile=1版本已通过SDK编译、完整临时下载，size=53216/1200/127760字节，OCM末地址0x2F310；请求用户确认15秒后文字界面与稳定性。日志：`build/panel_reference_hw_spi_build.log`、`panel_reference_hw_spi_download.log`。当前下载产物在`build/export/`，首个成功GPIO版本备份不变。

硬件SPI运行检查：ID=0x4C410101、screen_ok=1、last_paint=0x6B2E（非零）、GPIO=7、SPI CR=0x186/SR=0x25；检查后CPU恢复运行。日志：`build/panel_reference_hw_spi_verify.log`。等待用户确认该发送方式下的实际画面，不能用寄存器通过替代实物观察。

## 点亮未能复现与独立循环测试（2026-10-30）

用户随后反馈硬件SPI/profile=1版本“又变成白屏”。从`build/diagnostic/first_light_gpio/`恢复原ELF/map并重新完整下载后，用户仍反馈白屏；哈希核对导出ELF与首次点亮备份完全相同（SHA256=351ecd9d4f126702288f27787e8e26ecacd686a40d39a73e34656a398c46f81a）。运行检查screen_ok=1、last_paint非零、GPIO=0x8F，CPU在应用中并已恢复运行。故首次点亮只是一次用户观察，尚未稳定复现，不能认定屏幕已完成验收，也不能断言唯一原因是硬件SPI速度或初始化缺项。

硬件SPI管脚回环：保持屏幕CS高，不向屏幕选中发送；MOSI经V18 IOBUF读回连到SPI MISO。直接MMIO发送00/FF/AA/55/96/69/01/80/7E/81，十项收发字节全部一致；未启用SPI内部loopback。它只覆盖FPGA近端SDA及内部SPI采样，不证明屏幕端SCK/CS/DC的动态时序或电气质量。首次诊断脚本误把0x100作为手动片选位，未启动发送，并错误读取空RX FIFO而触发外部abort；该次无效。根据本机2018.2 BSP头文件更正：manual SS=0x80、inhibit=0x100，启动CR=0x86；更正脚本还在读取前检查RX非空。更正后十项回环通过。日志：`build/spi_pad_loopback_corrected.log`。两次脚本均在结束时恢复显示GPIO并恢复CPU。

当前临时设置`TFT_SOFTWARE_SPI=1`、`TFT_INIT_PROFILE=1`、`TFT_READBACK_PROBE=0`、`TFT_DIAGNOSTIC_LOOP=1`。独立循环用同一显示驱动持续输出全屏红、绿、蓝、黑、白，每帧发送完停2秒，暂不进入菜单、不运行协议采集调度、不发送读寄存器命令。此模式用于观察持续像素写入是否有效，不能当作正式应用验收。

SDK编译通过，诊断ELF size=47936/1200/92416字节，链接末地址0x22900；导出产物此时为诊断版本，与前述完整应用的size不同。已完整临时下载，等待用户观察至少30秒；日志：`build/panel_solid_loop_build.log`、`panel_solid_loop_download.log`。诊断变量符号：screen_ok=0xC048，tft_test_color=0x140BC，tft_test_frames=0x140C0。旧应用的调试地址不适用于当前诊断ELF。

诊断程序运行检查：screen_ok=1、tft_test_color=4、tft_test_frames=9，CPU位于应用中，检查后恢复运行。日志：`build/solid_loop_verify_1.log`。用户观察至少30秒后反馈“始终均匀白屏”，因此关闭读取、去除菜单并持续发送像素也未解决。当前没有可稳定复现的点亮结果。

下一项为不修改任何程序/参数的冷启动对照：已请用户整板关闭电源约5秒、确认指示灯熄灭后重新上电，随后重新下载同一GPIO/profile=1独立色块程序。等待用户确认断电上电，尚未再次下载；不能将此前热复位/更换程序的结果等同于本次冷启动测试。

用户已确认整板断电约5秒并重新上电；已完整下载同一份独立色块诊断程序，未改源码、初始化数值或引脚。下载日志：`build/panel_solid_loop_cold_download.log`。已请求保持供电、不复位观察30秒，画面结果待反馈。

冷启动运行检查：screen_ok=1、test_color=2、test_frames=8，CPU在应用中且检查后恢复运行。用户最终反馈仍然均匀白屏，冷启动没有解决。日志：`build/solid_loop_cold_verify.log`。

进一步将实际`firmware/src/tft.c`与主机GPIO/时间桩一起编译，用独立串行接收模型解析每一次GPIO写入，检查8位MSB优先帧、CS不在字节中间解除、DC不在字节内改变、退出休眠到开显示至少120ms、RGB565模式、每行128像素及连续128行地址。强制发送五种纯色，共核对163840个像素数据字节，全部通过。日志/重放源码位于`build/tft_contract/`。这仅证明软件产生的逻辑序列符合这些契约；不验证模块专用电源/Gamma参数，也不代替真实屏幕端波形测量。

当前结论：屏幕端供电/静态信号已测，软件逻辑序列及FPGA近端硬件SPI回环已有检查，但显示未稳定复现。下一步需要HD14008H14 JY这块模块的实际卖家配套代码/接线资料，或屏幕端SCL/SDA/CS/DC动态波形，不能据现有证据认定屏幕已损坏或宣称已修复。板上保留低速纯写入的循环色块诊断，仍是JTAG易失性启动。
