chronox142857/FPGA2026/examples/st7735s_pl/reference/stm32_csdn_original/main.c

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
/* Includes ------------------------------------------------------------------*/
#include "main.h"
#include "usart.h"
#include "gpio.h"

/* USER CODE BEGIN Includes */
#include "stdio.h"//必须增加标准库的定义，才能调用printf函数。
#include "bsp_lcd.h"
#include "bsp_font.h"
#include "bsp_picture.h"
/* USER CODE END Includes */


void SystemClock_Config(void);
/**
  * @brief  The application entry point.
  * @retval int
  */
int main(void)
{
  /* USER CODE BEGIN 1 */
	static unsigned char i=0;


  /* USER CODE END 1 */

  /* MCU Configuration--------------------------------------------------------*/

  /* Reset of all peripherals, Initializes the Flash interface and the Systick. */
  HAL_Init();

  /* Configure the system clock */
  SystemClock_Config();

  /* Initialize all configured peripherals */
  MX_GPIO_Init();
  MX_USART1_UART_Init();
  /* USER CODE BEGIN 2 */

	LCD_Init();  //液晶屏初始化
	LCD_BL_ON; //打开LCD显示屏的背光

	printf("LCD测试实验\n\r");	
	Full_Display_Color(RED);//全屏显示红色
	HAL_Delay(500);
	Full_Display_Color(GREEN);//全屏显示绿色
	HAL_Delay(500);
	Full_Display_Color(BLUE);//全屏显示蓝色
	HAL_Delay(500);
	Full_Display_Color(BLACK);//全屏显示黑色
	HAL_Delay(500);
	Full_Display_Color(WHITE);//全屏显示白色
	HAL_Delay(500);

//	从X和Y的坐标轴(0,0)开始，向下画一条直线 
	for(i=0; i<8; i++ )	Draw_Point(0, i, RED);
	HAL_Delay(1000);

//	在坐标X和Y，以字体为红色，背景为灰色，将数组Font_Image_test里面的第i个汉字打印出来
	for(i=0; i<4; i++ ) Display_Font(32*i,0,RED,GRAY0,Font_Image_test,i);
	for(i=0; i<4; i++ ) Display_Font(32*i,32,BLUE,GRAY0,Font_Image_test,4+i);

//	在坐标X和Y,以字体为红色，背景为灰色，显示英文字体
	Display_String(10,80,BLACK,RED,"STM32F103R6HAL");
	Display_String(10,100,BLACK,RED,"demo test!");
	HAL_Delay(1000);

	Display_Picture(Image_test);//全屏显示图片
	HAL_Delay(500);

  /* USER CODE END 2 */
  /* Infinite loop */
  /* USER CODE BEGIN WHILE */
  while (1)
  {
    /* USER CODE END WHILE */

    /* USER CODE BEGIN 3 */
  }
  /* USER CODE END 3 */
}

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
/* USER CODE BEGIN 4 */

int fputc(int ch, FILE *f)//单字节命令发送
{
  HAL_UART_Transmit(&huart1, (uint8_t *)&ch, 1, 0xffff);
  return ch;
}
 
int fgetc(FILE * f)//单字节命令接受
{ 
  uint8_t ch = 0; 
  HAL_UART_Receive(&huart1,&ch, 1, 0xffff); 
  return ch; 
}

/* USER CODE END 4 */
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
