chronox142857/FPGA2026/(commit log)

2026-10-30 Integrate analyzer capture and protocol UI with verified ST7735S PL driver
2026-10-31 Validate UART loopback and recover clipped or malformed frames
2026-10-31 Record SPI four-mode physical loopback validation
2026-10-31 Record recurring partial display corruption and full-frame recovery
2026-10-31 Restore SD application handoff and document STM32 source requirements
